Bastlirovo/esp32c3-minimal-devboard-v1/README.md

# esp32c3-minimal-devboard-v1
 Minimal devboard for ESP32-C3F module
