Bastlirovo/esp32c3-minimal-devboard-v1/HW/v1/esp32c3-devboard_BOT.png

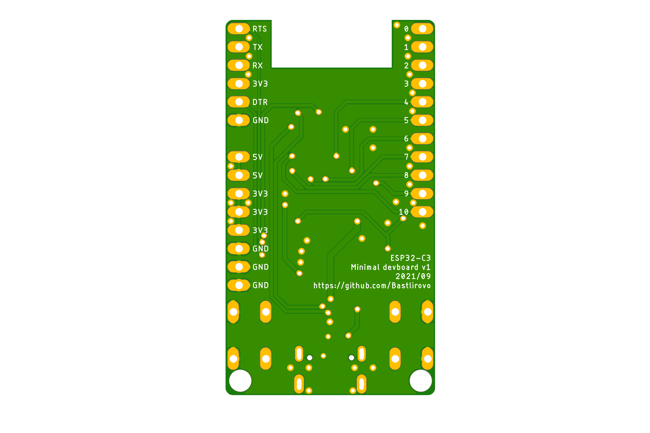
HW/v1/esp32c3-devboard_BOT.png
