Bastlirovo/esp32c3-minimal-devboard-v1/BOM/esp32c3-devboard-BOM.xls

Qty | Value | Device | Package | Parts | Description | Price [Kc] | Link
2 |  | 10-XX | B3F-10XX | BOOT, RST | OMRON SWITCH | 8 | https://cz.farnell.com/omron/b3f-1000/switch-spno-0-05a-24v-tht-0-98n/dp/176432
1 |  | PINHD-1X11 | 1X11 | GPIO | PIN HEADER | 32 | https://cz.farnell.com/molex/22-28-4250/connector-header-25pos-1row-2/dp/3049551
1 |  | PINHD-1X6 | 1X06 | UART | PIN HEADER
1 |  | PINHD-1X8 | 1X08 | POWER | PIN HEADER
2 | 100n | C-EUC0603 | C0603 | C3, C6 | CAPACITOR, European symbol | 1 | https://cz.farnell.com/multicomp/mc0603b104k100ct/cap-0-1-f-10v-10-x7r-0603/dp/2627427
3 | 10k | R-EU_R0603 | R0603 | R1, R2, R7 | RESISTOR, European symbol | 1 | https://cz.farnell.com/multicomp/mcwr06x103-jtl/res-10k-5-0-1w-0603-thick-film/dp/2694689
3 | 10u | C-EUC0603 | C0603 | C1, C2, C4 | CAPACITOR, European symbol | 11 | https://cz.farnell.com/samsung-electro-mechanics/cl10a106kq8nnnc/cap-10uf-6-3v-mlcc-0603/dp/3013387
1 | 1u | C-EUC0603 | C0603 | C5 | CAPACITOR, European symbol | 1 | https://cz.farnell.com/samsung-electro-mechanics/cl10b105mo8nnwc/cap-1uf-16v-mlcc-0603/dp/3013421
2 | 22 | R-EU_R0603 | R0603 | R3, R4 | RESISTOR, European symbol | 1 | https://cz.farnell.com/multicomp/mcwr06x22r0ftl/res-22r-1-0-1w-thick-film/dp/2447301
2 | 5k1 | R-EU_R0603 | R0603 | R5, R6 | RESISTOR, European symbol | 1 | https://cz.farnell.com/multicomp/mcwr06x5101ftl/res-5k1-1-0-1w-0603-thick-film/dp/2447404
2 | BC847 | BC847 | SOT23 | T1, T2 | NPN TRANSISTOR | 12 | https://cz.farnell.com/on-semiconductor/bc847blt3g/transistor-bipol-npn-45v-sot-23/dp/2533307?st=bc847
1 | BLM18PG221SN1D | INDUCTOR-0603-33NH | 603 | L1 | Inductors | 2 | https://cz.farnell.com/murata/blm18pg221sn1d/ferrite-bead-0-1ohm-1-4a-0603/dp/1515740?st=blm18pg221sn1d
1 | ESP32-C3F 2M | ESP32-C3F | ESP32-C3F | U3 |  | 50 | https://lcsc.com/product-detail/WiFi-Modules_Ai-Thinker-ESP32-C3F-2M_C2830867.html
1 | HRO_31_M_12_USB_C | HRO_31_M_12_USB_C | HRO_31_M_12_USB_C | J1 | USB Shielded I/O Receptacle; Type C; Right Angle; Surface Mount; Gold over Nickel | 8 | https://lcsc.com/product-detail/USB-Connectors_Korean-Hroparts-Elec-TYPE-C-31-M-12_C165948.html
1 | HT7833 | HT7833 | SOT89 | U1 |  | 10 | https://lcsc.com/product-detail/Linear-Voltage-Regulators-LDO_Holtek-Semicon-HT7833_C50936.html
1 | XC6210 | XC6210 | SOT-23-5 | U2 |  | 32 | https://cz.farnell.com/torex/xc6210b332mr/ic-v-reg-cmos-ldo-3-3v-smd-6210/dp/1057803?st=xc6210
