Bastlirovo/esp32c3-minimal-devboard-v1/HW/v1/esp32c3-devboard_schematic.pdf

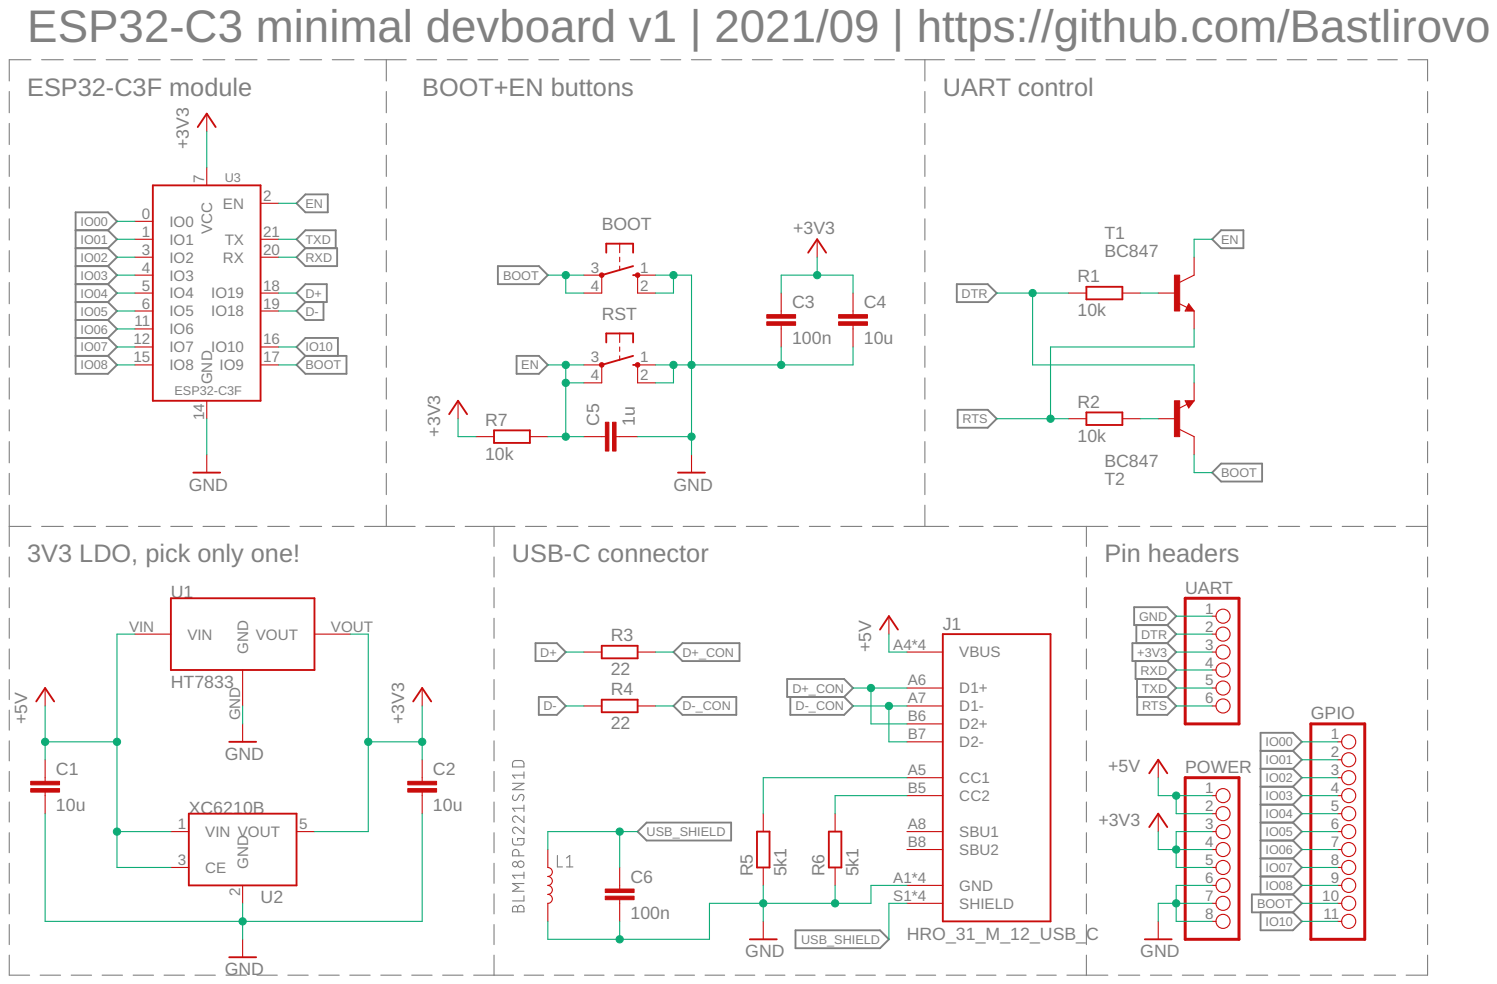
[picture p3: page 1]

ESP32-C3 minimal devboard v1 | 2021/09 | https://github.com/Bastlirovo
