Bastlirovo/esp32c3-minimal-devboard-v1/HW/v1/esp32c3-devboard.brd

## EAGLE design HW/v1/esp32c3-devboard.brd (2021-10-13)

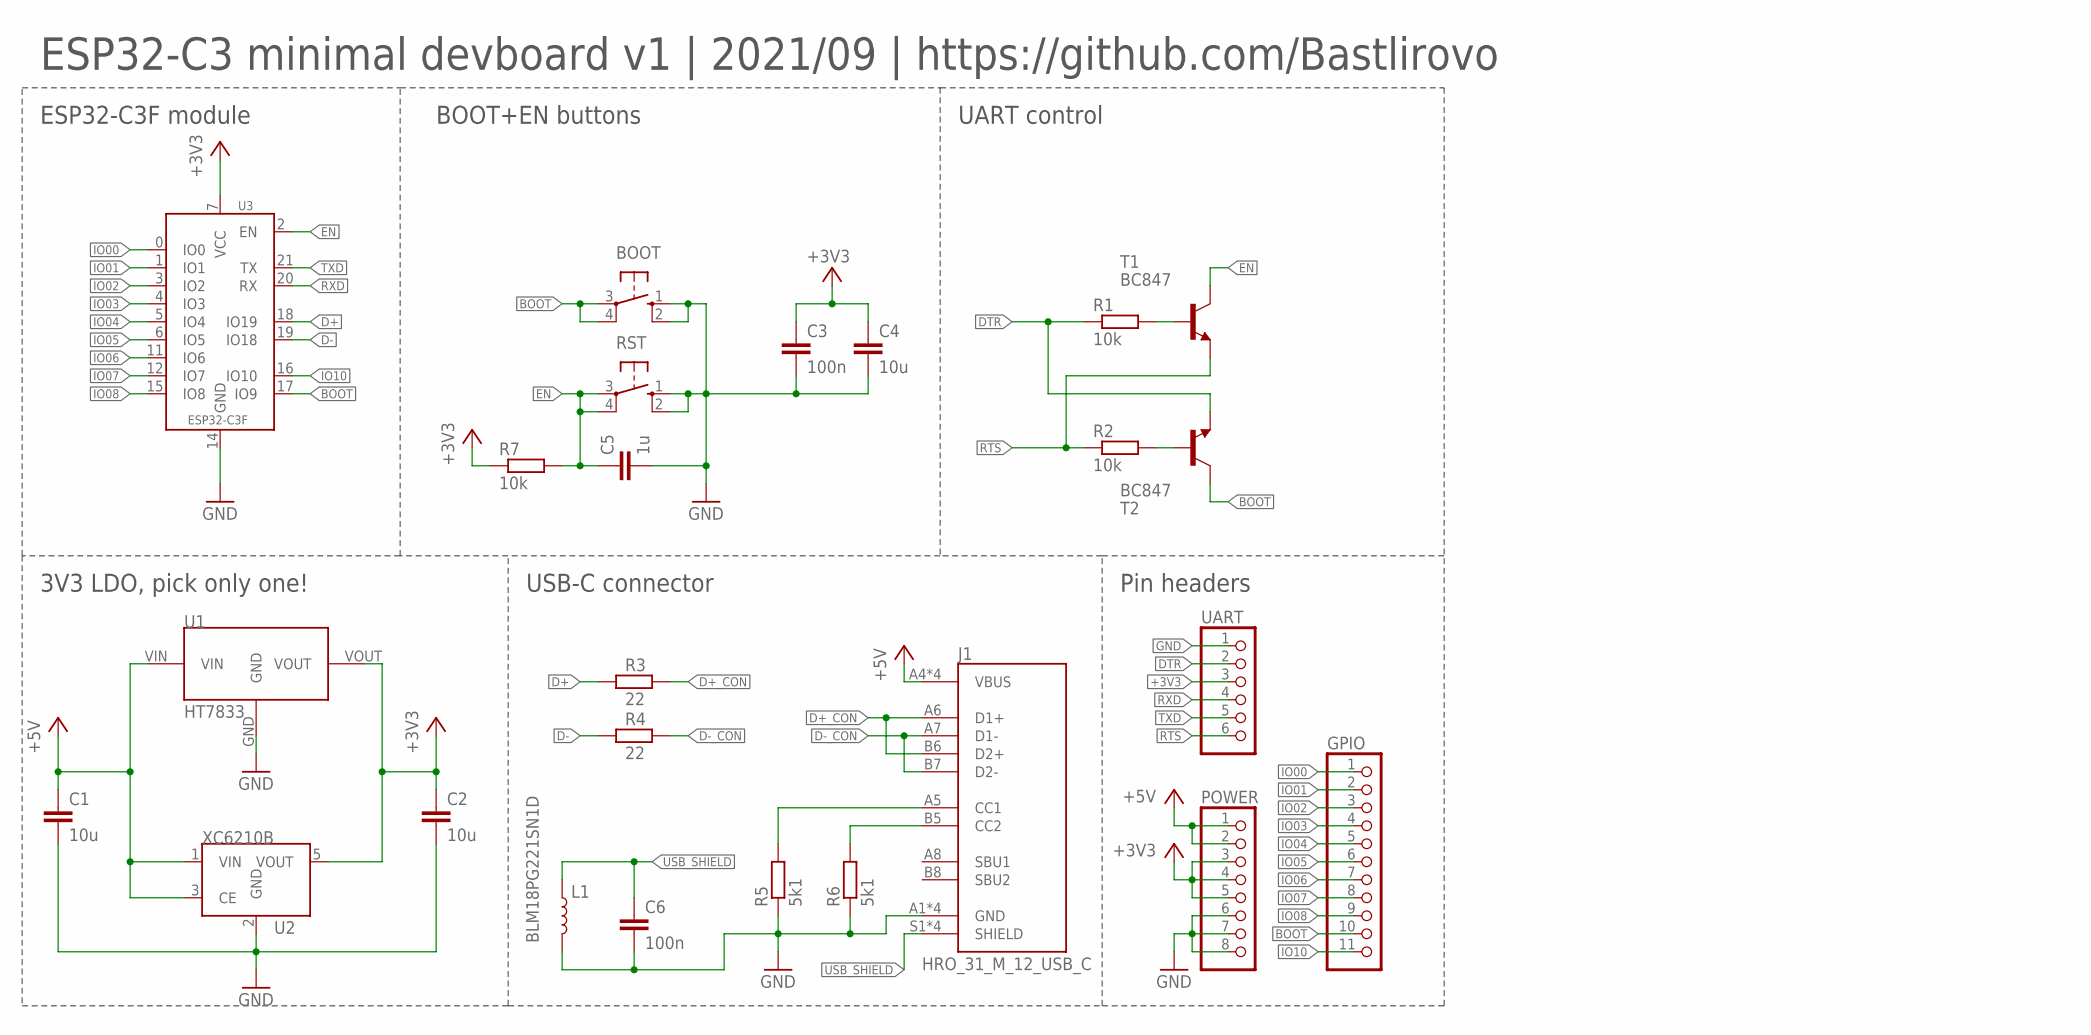
[picture p4: schematic esp32c3-devboard.sch]

Parts:
BOOT: 10-XX; B3F-10XX
C1, C2, C4: 10u; C0603
C3, C6: 100n; C0603
C5: 1u; C0603
GPIO: PINHD-1X11; 1X11
J1: HRO_31_M_12_USB_C
L1: BLM18PG221SN1D; 0603
POWER: PINHD-1X8; 1X08
R1, R2, R7: 10k; R0603
R3, R4: 22; R0603
R5, R6: 5k1; R0603
RST: 10-XX; B3F-10XX
T1, T2: BC847; SOT23
U1: HT7833; SOT89
U2: XC6210; SOT-23-5
U3: ESP32-C3F
UART: PINHD-1X6; 1X06

Connections:
+3V3: C2.1, C3.1, C4.1, POWER.3, POWER.4, POWER.5, R7.1, U1.VOUT, U2.5 (VOUT), U3.7 (VCC), UART.3
+5V: C1.1, J1.A4 (VBUS), J1.A9 (VBUS), J1.B4 (VBUS), J1.B9 (VBUS), POWER.1, POWER.2, U1.VIN, U2.1 (VIN), U2.3 (CE)
BOOT: BOOT.3, BOOT.4 (P1), GPIO.10, T2.3 (C), U3.17 (IO9)
D+: R3.1, U3.18 (IO19)
D+_CON: J1.A6 (D1+), J1.B6 (D2+), R3.2
D-: R4.1, U3.19 (IO18)
D-_CON: J1.A7 (D1-), J1.B7 (D2-), R4.2
DTR: R1.1, T2.2 (E), UART.2
EN: C5.1, R7.2, RST.3, RST.4 (P1), T1.3 (C), U3.2 (EN)
GND: BOOT.1 (S), BOOT.2 (S1), C1.2, C2.2, C3.2, C4.2, C5.2, C6.2, J1.A1 (GND), J1.A12 (GND), J1.B1 (GND), J1.B12 (GND), L1.2, POWER.6, POWER.7, POWER.8, R5.1, R6.1, RST.1 (S), RST.2 (S1), U1.GND, U2.2 (GND), U3.14 (GND), UART.1
IO00: GPIO.1, U3.0 (IO0)
IO01: GPIO.2, U3.1 (IO1)
IO02: GPIO.3, U3.3 (IO2)
IO03: GPIO.4, U3.4 (IO3)
IO04: GPIO.5, U3.5 (IO4)
IO05: GPIO.6, U3.6 (IO5)
IO06: GPIO.7, U3.11 (IO6)
IO07: GPIO.8, U3.12 (IO7)
IO08: GPIO.9, U3.15 (IO8)
IO10: GPIO.11, U3.16 (IO10)
unnamed: R2.2, T2.1 (B)
unnamed: R1.2, T1.1 (B)
unnamed: J1.A5 (CC1), R5.2
unnamed: J1.B5 (CC2), R6.2
RTS: R2.1, T1.2 (E), UART.6
RXD: U3.20 (RX), UART.4
TXD: U3.21 (TX), UART.5
USB_SHIELD: C6.1, J1.S1 (SHIELD), J1.S2 (SHIELD), J1.S3 (SHIELD), J1.S4 (SHIELD), L1.1

Notes on the sheet:
ESP32-C3F module
BOOT+EN buttons
UART control
3V3 LDO, pick only one!
USB-C connector
Pin headers
ESP32-C3 minimal devboard v1 | 2021/09 | https://github.com/Bastlirovo

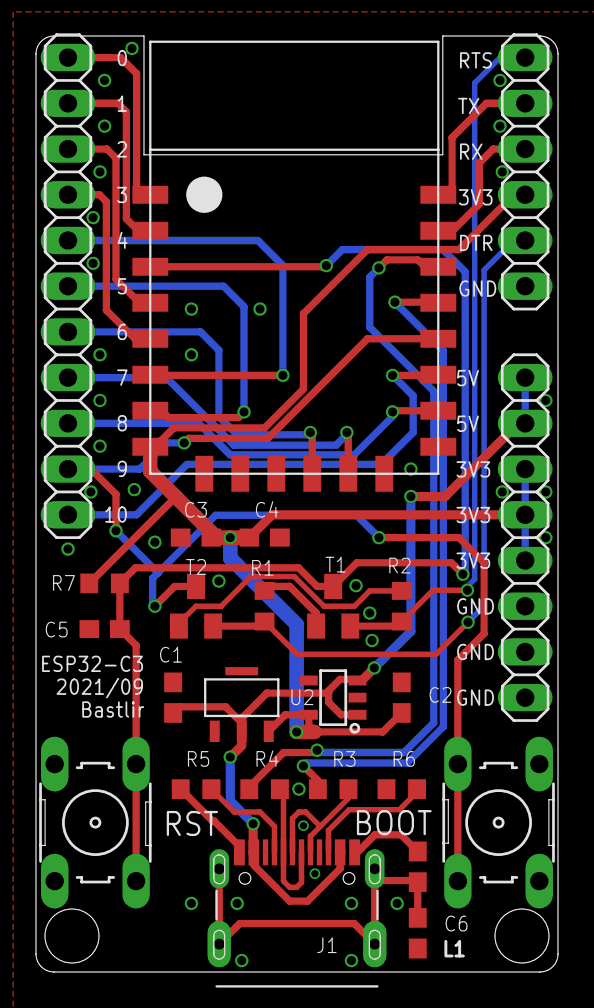
[picture p5: board esp32c3-devboard.brd from above]

Board: 2 copper layers, 29.0 x 52.0 mm, 25 parts (0 on the bottom side), 28 nets.
