Bastlirovo/esp32c3-minimal-devboard-v1/(commit log)

2021-10-13 Initial commit of HW v1
    [esp32c3-devboard.brd, esp32c3-devboard.sch]
2021-10-13 Added BOM with links
    [esp32c3-devboard-BOM.xls]
